Beatzoid/record-player/BOM.md

# Mini Record Player — bill of materials

<!-- Generated by Half Life from project cmuowf9to022g01s1qy0gn62q. Edits here are overwritten on the next sync. -->
<!-- Generated: 1970-01-01T00:00:00.000Z -->

> [!NOTE]
> This parts list is mirrored from [Half Life](https://halflife.hackclub.com). Editing it here will not change the platform's copy, and the next sync overwrites this file.

| Week | Tier | Parts funding |
| --- | --- | --- |
| Warm-up | Tier 3 | $100.00 |

_No parts listed yet._
