Beatzoid/record-player/(list of files, drawings)

Other design files:
record_player.PcbDoc
Record_Player.PrjPcb
record_player.SchDoc
