Beatzoid/record-player/(commit log)

2026-08-05 Arduino code
2026-08-05 Make arduino IDE happy
2026-09-23 Working Before Wires
    [Ports.SchDoc]
2026-09-24 Add RFID & Motor Cutout, & Re-arrange Wiring
    [Ports.PcbDoc, Ports.SchDoc]
2026-10-01 Fix image formatting in README.md
    Updated image syntax in README for the first prototype.
2026-10-01 Update JOURNAL.md with project progress and details
    Expanded the devlog for the miniature record player project, detailing the ideation, research, parts, initial prototype, and PCB design iterations.
2026-10-07 Enhance README with project details and updates
    Expanded the README to include detailed project ideation, research, parts list, initial prototype development, PCB design, manufacturing process, code structure, and future improvements.
